ARCHMAJ/MCP39F511_Breakout/doc/app_note_circuit.png

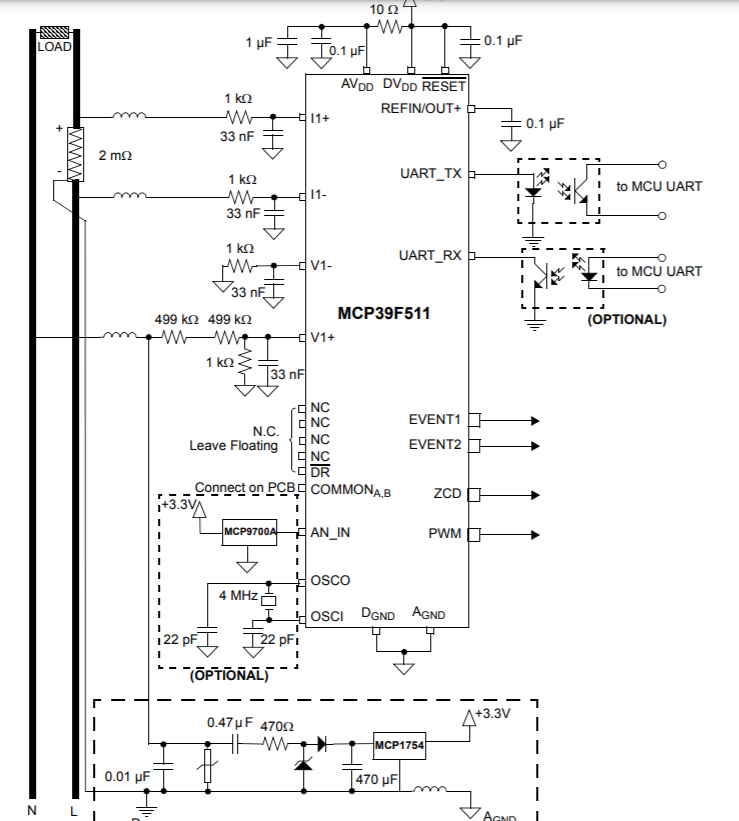
doc/app_note_circuit.png
