ARCHMAJ/MCP39F511_Breakout/bom/MCP39F511_Breakout.xlsx

References | manf# | Value | Footprint | Quantity
C6, C7, C8, C9 | 0603YC333KAT2A | 33n | C_0603_1608Metric | 4
C3, C5 | C0603C104K4PACTU | 100n | C_0603_1608Metric | 2
C4 | C0603C105K4PAC7411 | 1u | C_0603_1608Metric | 1
C1, C2 | C0603C220M4RACTU | 22p | C_0603_1608Metric | 2
R4, R5 | CRL0603-FW-2R40ELF | 2.4R | R_0603_1608Metric | 2
R8, R9 | RC0603FR-0710KL | 10K | R_0603_1608Metric | 2
R1 | RC0603FR-0710RP | 10R | R_0603_1608Metric | 1
R2, R3, R6, R7 | RT0603FRE071KL | 1K | R_0603_1608Metric | 4
U1 | MCP39F511-E/MQ | MCP39F511-E_MQ | QFN50P500X500X100-29N | 1
U2 | MCP9700T-E/TT | MCP9700T-ETT | SOT-23 | 1
Y1 | LFXTAL003071Reel | 4MHz / 16pF | Crystal_SMD_HC49-SD | 1
