ARCHMAJ/MCP39F511_Breakout/doc/schematic.pdf

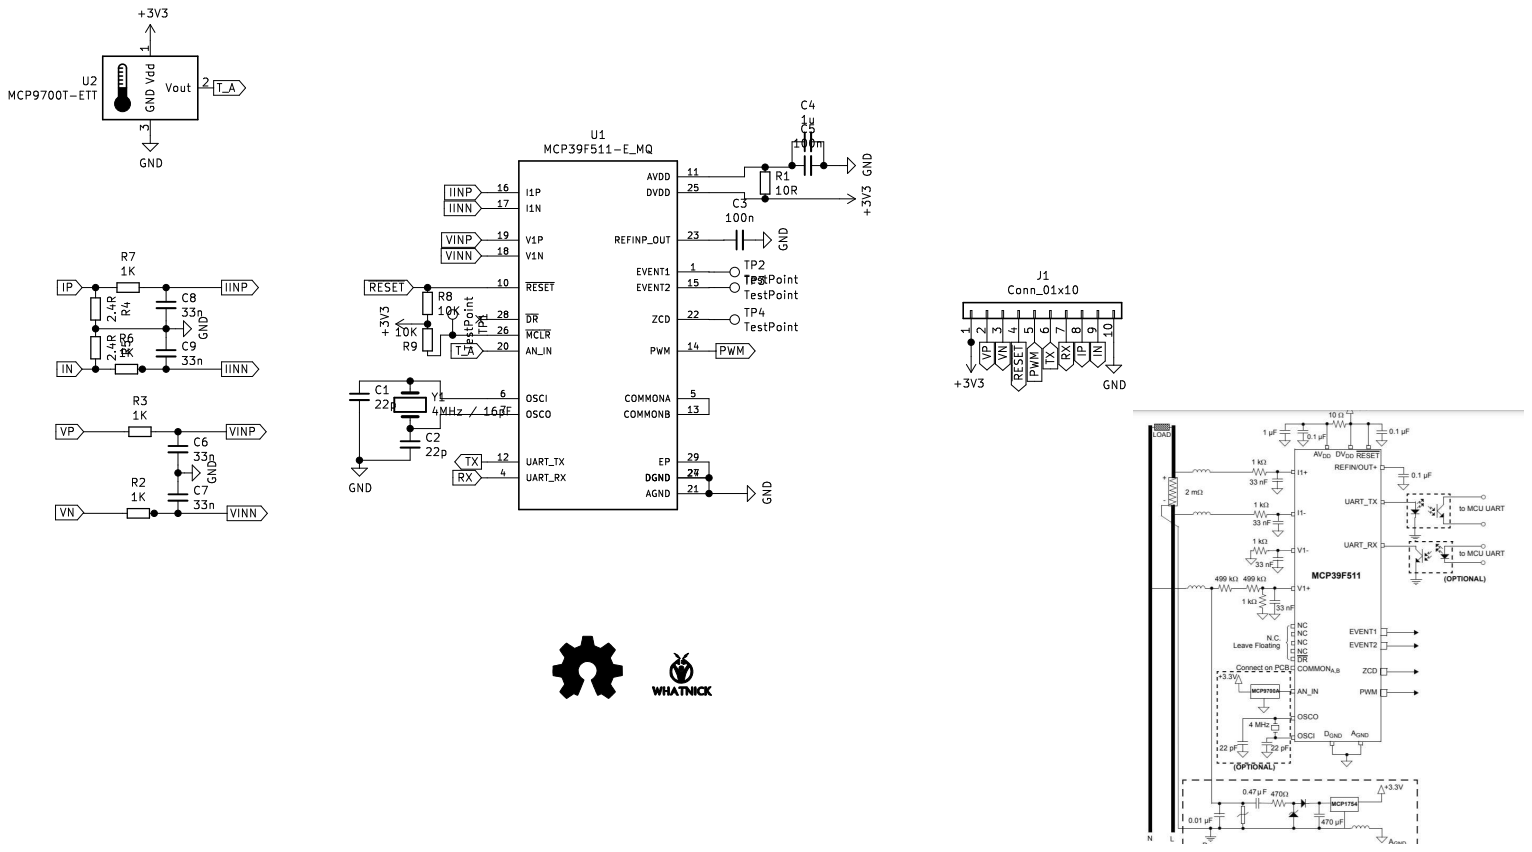
[picture p2: page 1]
