ARCHMAJ/MCP39F511_Breakout/MCP39F511_Breakout.kicad_pcb

## KiCad design MCP39F511_Breakout.kicad_pcb (2020-12-17)

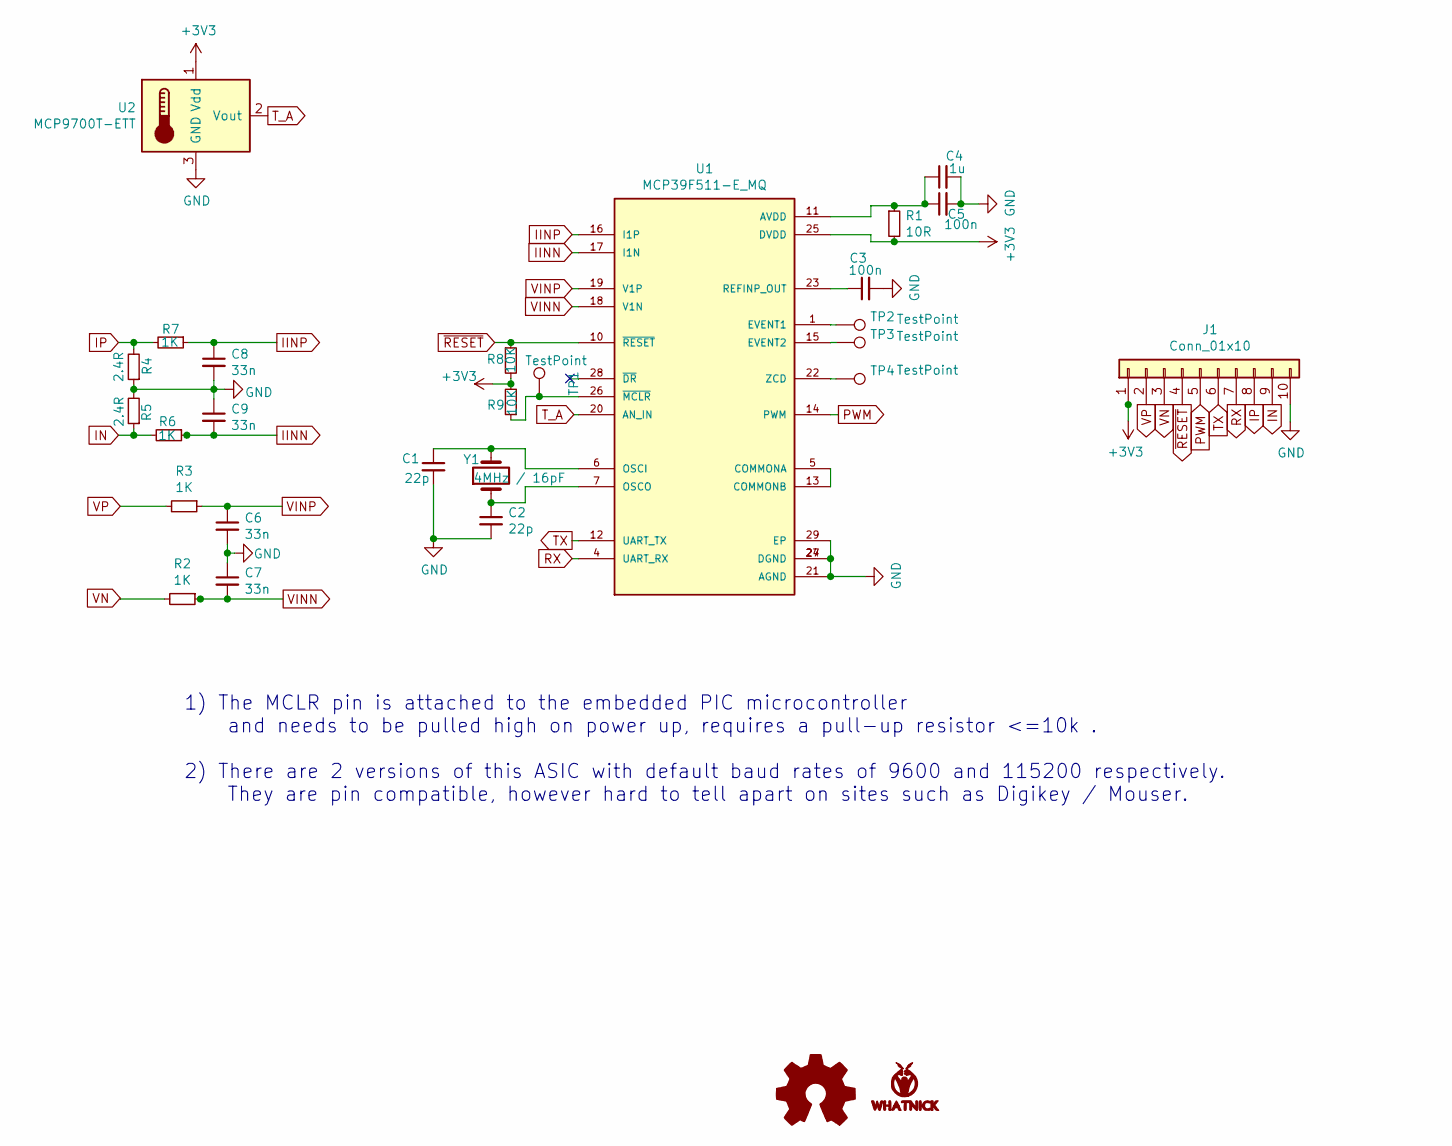
[picture p3: schematic MCP39F511_Breakout.kicad_sch]

Parts:
C1, C2: 22p; C_0603_1608Metric
C3, C5: 100n; C_0603_1608Metric
C4: 1u; C_0603_1608Metric
C6, C7, C8, C9: 33n; C_0603_1608Metric
J1: Conn_01x10; PinHeader_1x10_P2.54mm_Vertical
LOGO1: Logo_Open_Hardware_Small; OSHW-Logo2_7.3x6mm_SilkScreen
LOGO2: LOGO; Whatnick_logo
R1: 10R; R_0603_1608Metric
R2, R3, R6, R7: 1K; R_0603_1608Metric
R4, R5: 2.4R; R_0603_1608Metric
R8, R9: 10K; R_0603_1608Metric
TP1, TP2, TP3, TP4: TestPoint; TestPoint_Pad_D2.0mm
U1: MCP39F511-E_MQ; QFN50P500X500X100-29N; PARTREV B
U2: MCP9700T-ETT; SOT-23
Y1: 4MHz / 16pF; Crystal_SMD_HC49-SD

Connections:
+3V3: J1.1, R1.2, R8.2, R9.2, U1.25 (DVDD), U2.1 (Vdd)
GND: C1.2, C2.2, C3.2, C4.2, C5.2, C6.2, C7.1, C8.2, C9.1, J1.10, R4.1, R5.2, U1.21 (AGND), U1.24 (DGND), U1.27 (DGND), U1.29 (EP), U2.3 (GND)
IINN: C9.2, R6.1, U1.17 (I1N)
IINP: C8.1, R7.1, U1.16 (I1P)
IN: J1.9, R5.1, R6.2
IP: J1.8, R4.2, R7.2
unnamed: C1.1, U1.6 (OSCI), Y1.2
unnamed: C2.1, U1.7 (OSCO), Y1.1
unnamed: C3.1, U1.23 (REFINP_OUT)
unnamed: C4.1, C5.1, R1.1, U1.11 (AVDD)
unnamed: R9.1, TP1.1, U1.26 (~MCLR)
unnamed: TP2.1, U1.1 (EVENT1)
unnamed: TP3.1, U1.15 (EVENT2)
unnamed: TP4.1, U1.22 (ZCD)
unnamed: U1.5 (COMMONA), U1.13 (COMMONB)
PWM: J1.5, U1.14 (PWM)
RX: J1.7, U1.4 (UART_RX)
TX: J1.6, U1.12 (UART_TX)
T_A: U1.20 (AN_IN), U2.2 (Vout)
VINN: C7.2, R2.1, U1.18 (V1N)
VINP: C6.1, R3.1, U1.19 (V1P)
VN: J1.3, R2.2
VP: J1.2, R3.2
~RESET: J1.4, R8.1, U1.10 (~RESET)

Notes on the sheet:
1) The MCLR pin is attached to the embedded PIC microcontroller and needs to be pulled high on power up, requires a pull-up resistor <=10k . 2) There are 2 versions of this ASIC with default baud rates of 9600 and 115200 respectively. They are pin compatible, however hard to tell apart on sites suc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

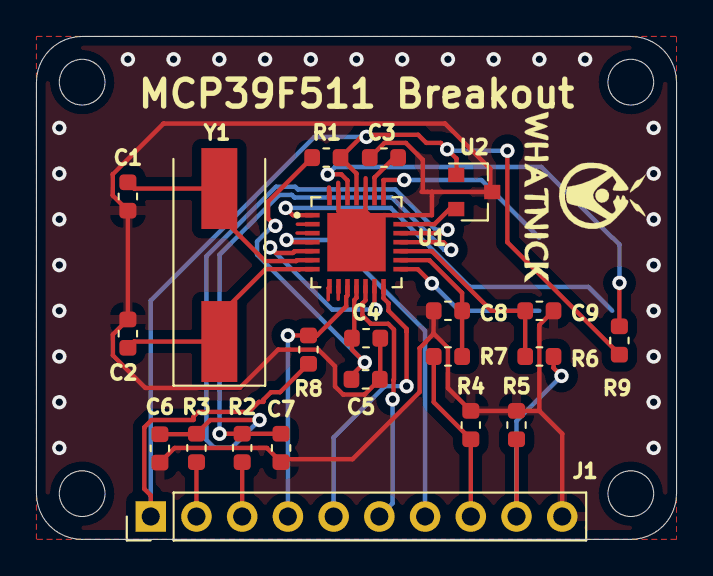
[picture p4: board MCP39F511_Breakout.kicad_pcb from above]

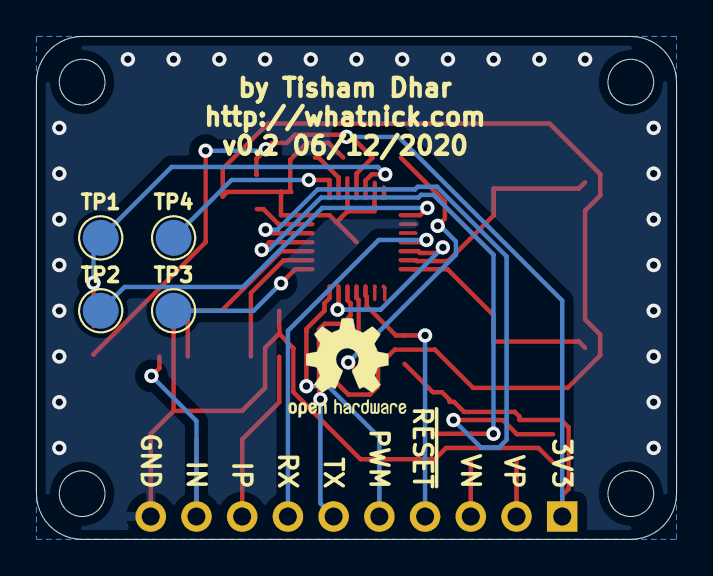
[picture p5: board MCP39F511_Breakout.kicad_pcb from below]

Board: 2 copper layers, 35.6 x 27.9 mm, 28 parts (5 on the bottom side), 24 nets.
