ARCHMAJ/MCP39F511_Breakout/(commit log)

2020-11-13 Initial import
    [MCP39F511_Breakout.kicad_pcb, MCP39F511_Breakout.sch]
2020-11-13 PCB Edge cuts
    [MCP39F511_Breakout.kicad_pcb, MCP39F511_Breakout.sch]
2020-11-14 Initial complete schematic
    [MCP39F511_Breakout.kicad_pcb, MCP39F511_Breakout.kicad_sch]
2020-11-14 Add circuit from appnote
    [MCP39F511_Breakout.kicad_sch]
2020-11-14 Finish routing and silk-screens
    [MCP39F511_Breakout.kicad_pcb, MCP39F511_Breakout.kicad_sch]
2020-11-15 Add gerbers
    [MCP39F511_Breakout-B_Cu.gbl, MCP39F511_Breakout-B_Mask.gbs, MCP39F511_Breakout-B_Paste.gbp, MCP39F511_Breakout-B_Silkscreen.gbo, MCP39F511_Breakout-Edge_Cuts.gm1, MCP39F511_Breakout-F_Cu.gtl, MCP39F511_Breakout-F_Mask.gts, MCP39F511_Breakout-F_Paste.gtp]
2020-11-22 Do an iBOM run
    [MCP39F511_Breakout.kicad_sch]
2020-11-22 Do a MPN included iBOM run
    [MCP39F511_Breakout.kicad_sch]
2020-11-22 Update BOM
    [MCP39F511_Breakout.kicad_pcb, MCP39F511_Breakout.kicad_sch, MCP39F511_Breakout.xlsx]
2020-12-06 Add longer fillets to pads
    [MCP39F511_Breakout.kicad_pcb]
2020-12-06 New manufacture files
    [MCP39F511_Breakout-B_Cu.gbl, MCP39F511_Breakout-B_Mask.gbs, MCP39F511_Breakout-B_Paste.gbp, MCP39F511_Breakout-B_Silkscreen.gbo, MCP39F511_Breakout-Edge_Cuts.gm1, MCP39F511_Breakout-F_Cu.gtl, MCP39F511_Breakout-F_Mask.gts, MCP39F511_Breakout-F_Paste.gtp]
2020-12-06 Footprint positions
    [MCP39F511_Breakout-all-pos.csv]
2020-12-10 Add MCLR pullup
    [MCP39F511_Breakout-B_Cu.gbl, MCP39F511_Breakout-B_Mask.gbs, MCP39F511_Breakout-B_Paste.gbp, MCP39F511_Breakout-B_Silkscreen.gbo, MCP39F511_Breakout-Edge_Cuts.gm1, MCP39F511_Breakout-F_Cu.gtl, MCP39F511_Breakout-F_Mask.gts, MCP39F511_Breakout-F_Paste.gtp]
2020-12-10 Update BOM, positions for new pullup
    [MCP39F511_Breakout.xlsx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]
2020-12-10 Schematic pdf
2020-12-12 Remove old schematic
    [MCP39F511_Breakout.sch]
2020-12-17 Schematic Cleanup, Notes added, PCB cleanup
    [MCP39F511_Breakout.kicad_pcb, MCP39F511_Breakout.kicad_sch]
